young-whites/smart-fish-tank/stm32Code-official/README.md

# 基于 STM32 的智能鱼缸监控系统

## 项目简介

本项目是一款基于 STM32F103C8T6 的智能鱼缸监控系统，通过传感器实时采集水质参数（温度、水位、PH、空气质量），自动控制加热、加水、排水、增氧等执行机构，并通过 OLED 本地显示与 WiFi（ESP-01S）远程上报实现双通道人机交互。

### 核心功能

- **温度监控**：DS18B20 采集水温，滞环控制加热继电器
- **水位监控**：模拟水位传感器，区间控制加水/排水继电器
- **PH 监测**：PH 传感器采集，越限报警
- **空气质量监测**：MQ-135 采集，超标自动增氧
- **OLED 显示**：SSD1306 128×64，3 主页面 × 多子页面
- **5 键交互**：独立按键导航、阈值设置、手动控制
- **自动喂食**：SG90 舵机定时/手动触发
- **WiFi 远程控制**：ESP-01S TCP Server，Android APP 连接控制
- **声光报警**：综合越限判断，蜂鸣器 + LED 循环报警

## 系统架构

```
┌─────────────┐      ┌──────────────┐      ┌─────────────┐
│  传感器阵列  │─────▶│  STM32F103   │─────▶│  执行器阵列  │
│ DS18B20     │      │   C8T6       │      │ 加热继电器  │
│ 水位传感器  │      │  72MHz       │      │ 加水继电器  │
│ MQ-135      │      │  裸机调度    │      │ 排水继电器  │
│ PH 传感器   │      │              │      │ 增氧继电器  │
└─────────────┘      │  ┌────────┐  │      │ SG90 舵机   │
                     │  │ TIM2   │  │      │ 蜂鸣器+LED  │
┌─────────────┐      │  │ 1ms    │  │      └─────────────┘
│  OLED 显示  │◀─────│  │ 中断   │  │
│  128×64     │      │  │ 调度   │  │      ┌─────────────┐
└─────────────┘      │  └────────┘  │─────▶│  ESP-01S    │
                     │              │      │  WiFi 模组  │
┌─────────────┐      │              │      │  TCP:8080   │────▶ Android APP
│  5 按键     │─────▶│              │      └─────────────┘
│  KEY1~5     │      └──────────────┘
└─────────────┘
```

## 硬件清单

| 器件 | 型号 | 接口 | 供电 |
|---|---|---|---|
| MCU | STM32F103C8T6 | — | 3.3V |
| 温度传感器 | DS18B20 | PB13 (1-Wire) | 3.3V |
| 水位传感器 | 模拟型 | PA1 (ADC1_IN1) | 3.3V |
| PH 传感器 | 模拟型 | PA0 (ADC1_IN0) | 3.3V |
| 空气质量传感器 | MQ-135 | PA4 (ADC1_IN4) | 5V |
| OLED 显示屏 | SSD1306 0.96" | PA11(SCL)/PA12(SDA) | 3.3V |
| WiFi 模组 | ESP-01S | PA2(TX)/PA3(RX) | 3.3V |
| 加热继电器 | — | PB12 | 5V |
| 加水继电器 | — | PB14 | 5V |
| 排水继电器 | — | PB15 | 5V |
| 增氧继电器 | — | PA15 | 5V |
| 舵机 | SG90 | PA6 (TIM3_CH1) | 5V |
| 按键 | 5 个轻触 | PA8/PB3/PB4/PB8/PB1 | — |
| 蜂鸣器+LED | — | PB9 | 3.3V |

## 目录结构

```
stm32Code-official/
├── MDK_Core/               # ARM Cortex-M3 内核文件
├── MDK_STM32F10x_FWLib/    # STM32 标准外设库
├── MDK_System/             # 系统底层（delay、USART1 调试）
├── MDK_APP/                # 应用层
│   ├── MyTypedef.c/h       #   全局数据结构 (Flag + Record)
│   ├── TimingSet.c/h       #   TIM2 中断调度函数
│   └── GeneralTIM.c/h      #   TIM2 定时器配置
├── MDK_Hardware/           # 硬件驱动
│   ├── OLED/               #   OLED 显示模块（驱动+渲染+字库）
│   ├── bsp_Key.c/h         #   按键驱动
│   ├── bsp_beep.c/h        #   蜂鸣器驱动
│   ├── bsp_led.c/h         #   LED 驱动
│   ├── bsp_esp01s.c/h      #   ESP-01S WiFi 驱动
│   ├── ds18b20.c/h         #   DS18B20 温度驱动
│   └── bsp_adc.c/h         #   ADC 采集驱动
├── MDK_User/               # 用户代码
│   ├── main.c              #   系统入口
│   └── stm32f10x_it.c/h    #   中断服务函数
├── MDK_Hardware/           # 硬件原理图/PCB
├── MDK_Project/            # Keil 工程文件
└── MDK_Doc/                # 项目文档
```

## 编译与烧录

### 开发环境

- IDE：Keil MDK-ARM v5
- 编译器：ARM Compiler v5/v6
- 目标芯片：STM32F103C8T6
- 调试器：ST-Link / J-Link

### 编译步骤

1. 使用 Keil MDK-ARM 打开 `MDK_Project/` 下的 `.uvprojx` 工程文件
2. 确认 Target 选择为 `STM32F103C8`
3. 点击 Build (F7) 编译
4. 编译成功后生成 `.hex` / `.bin` 文件

### 烧录步骤

1. 连接 ST-Link 调试器到 STM32 SWD 接口
2. Keil 中 Options for Target → Debug → 选择 ST-Link
3. 点击 Download (F8) 烧录
4. 或使用 ST-Link Utility 烧录 `.hex` 文件

## 文档索引

| 文档 | 说明 |
|---|---|
| [需求规格书](MDK_Doc/智能鱼缸系统需求规格书.md) | 系统功能需求、硬件需求、性能需求 |
| [业务逻辑流程图](MDK_Doc/智能鱼缸系统业务逻辑流程图.md) | 各模块业务流程、状态转换图 |
| [代码框架与业务流程](MDK_Doc/智能鱼缸系统代码框架与业务流程.md) | 代码目录、函数调用、数据流向 |
| [OLED 显示规划](MDK_Doc/OLED显示规划.md) | OLED 页面布局、字库、渲染逻辑 |
| [WiFi 通信协议规范](MDK_Doc/WiFi通信协议规范.md) | ESP-01S 通信协议、帧格式、命令字 |
| [测试用例表](MDK_Doc/测试用例表_可勾选.md) | 功能测试用例（可勾选） |
| [项目坑点与经验总结](MDK_Doc/项目坑点与经验总结.md) | 开发过程中遇到的问题与解决方案 |

## 版本信息

| 项目 | 内容 |
|---|---|
| 项目名称 | 基于 STM32 的智能鱼缸监控系统 |
| 目标 MCU | STM32F103C8T6 (72 MHz, 3.3V) |
| 开发环境 | Keil MDK-ARM v5 |
| 操作系统 | 裸机 (Bare-Metal)，TIM2 中断调度 |
| 配套 APP | [Android 控制端](../Android_Studio_Floder/Intelligent-fish-tank-control/) |

---

*最后更新：2026-05-19*
