young-whites/smart-fish-tank/Schematic/硬件接口说明.md

| 器件 | 型号 | 接口 | 供电 | 备注 |
|---|---|---|---|---|
| MCU | STM32F103C8T6 | - | 3.3V | LQFP-48, 72MHz |
| 温度传感器 | DS18B20 | 1-Wire (PB13) | 3.3V | 防水探头型 |
| 水位传感器 | 模拟输出 | ADC1_IN1 (PA1) | 3.3V | 0~100% |
| PH 传感器 | 模拟输出 | ADC1_IN0 (PA0) | 3.3V | 0.0~14.0 |
| 空气质量传感器 | MQ-135 | ADC1_IN4 (PA4) | 5V | 模拟输出 |
| OLED 显示屏 | SSD1306 0.96" | I2C (PA11/PA12) | 3.3V | 128×64 |
| WiFi 模组 | ESP-01S | USART2 (PA2/PA3) | 3.3V | AT 指令透传 |
| 加热继电器 | - | PB12 | 5V | 高电平有效 |
| 加水继电器 | - | PB14 | 5V | 高电平有效 |
| 排水继电器 | - | PB15 | 5V | 高电平有效 |
| 增氧继电器 | - | PA15 | 5V | 高电平有效 |
| 舵机 | SG90 | PWM TIM3_CH1 (PA6) | 5V | 0~180° |
| 按键 ×5 | 轻触 | (KEY1~KEY5)依次PA8/PB3/PB4/PB8/PB1 | - | 上拉输入，高电平触发 |
| 蜂鸣器+LED | 有源 | PB9 | 3.3V | 高电平触发 |
