young-whites/smart-fish-tank/stm32Code-official/MDK_Doc/智能鱼缸系统代码框架与业务流程.md

# 智能鱼缸系统 — 代码框架与业务流程

> 版本：V1.0 | 日期：2026-05-19
> 项目：基于 STM32 的智能鱼缸监控系统
> 目标 MCU：STM32F103C8T6 (72 MHz, 3.3 V)
> 开发环境：Keil MDK-ARM v5

---

## 目录

1. [代码目录结构](#1-代码目录结构)
2. [源文件职责清单](#2-源文件职责清单)
3. [函数调用关系](#3-函数调用关系)
4. [TIM2 中断调度详细流程](#4-tim2-中断调度详细流程)
5. [全局数据结构](#5-全局数据结构)
6. [模块间数据流向](#6-模块间数据流向)
7. [主循环业务逻辑](#7-主循环业务逻辑)
8. [中断优先级配置](#8-中断优先级配置)
9. [变更记录](#9-变更记录)

---

## 1. 代码目录结构

```
stm32Code-official/
├── keilkill.bat            # Keil 工程清理脚本
├── MDK_Core/               # ARM Cortex-M3 内核文件
│   ├── core_cm3.c/h        # CMSIS Cortex-M3 核心头文件
│   ├── startup_stm32f10x_md.s  # 启动文件（中容量）
│   └── system_stm32f10x.c/h    # 系统初始化
├── MDK_STM32F10x_FWLib/    # STM32 标准外设库
│   ├── stm32f10x_gpio.c/h  # GPIO 驱动
│   ├── stm32f10x_tim.c/h   # 定时器驱动
│   ├── stm32f10x_adc.c/h   # ADC 驱动
│   ├── stm32f10x_usart.c/h # USART 驱动
│   ├── stm32f10x_rcc.c/h   # 时钟配置
│   ├── stm32f10x_i2c.c/h   # I2C 驱动
│   ├── stm32f10x_it.c/h    # 中断向量表
│   └── misc.c/h            # NVIC 配置
├── MDK_System/             # 系统底层支持
│   ├── sys.c/h             # 系统宏定义
│   ├── delay.c/h           # 延时函数（SysTick）
│   └── usart.c/h           # 调试串口 USART1
├── MDK_APP/                # 应用层逻辑
│   ├── MyTypedef.c/h       # 全局数据结构（Flag + Record）
│   ├── TimingSet.c/h       # 定时中断调度函数
│   └── GeneralTIM.c/h      # TIM2 定时器配置
├── MDK_Hardware/           # 硬件驱动层
│   ├── OLED/               # OLED 显示模块
│   │   ├── oled_drive.c/h      # I2C 软件模拟底层驱动
│   │   ├── oled_ShowDrive.c/h  # 显示底层函数（画点/线/字）
│   │   ├── oled_show.c/h       # 页面渲染逻辑
│   │   ├── oled_IndexCtr.c/h   # 页面索引控制
│   │   ├── oledChinese_6X12.h  # 6×12 汉字字库
│   │   ├── oledChinese_8X16.h  # 8×16 汉字字库
│   │   ├── oledchar_6X12.h     # 6×12 ASCII 字库
│   │   └── icon.h              # 图标资源
│   ├── bsp_Key.c/h         # 按键驱动 + 事件处理
│   ├── bsp_beep.c/h        # 蜂鸣器驱动
│   ├── bsp_led.c/h         # LED 驱动
│   ├── bsp_esp01s.c/h      # ESP-01S WiFi 驱动
│   ├── ds18b20.c/h         # DS18B20 温度传感器驱动
│   └── bsp_adc.c/h         # ADC 多通道采集驱动
├── MDK_User/               # 用户代码
│   ├── main.c              # 系统入口
│   ├── stm32f10x_it.c/h    # 中断服务函数
│   └── stm32f10x_conf.h    # 外设库头文件包含配置
├── MDK_Hardware/           # 硬件原理图/PCB 文件
└── MDK_Project/            # Keil 工程文件 (.uvprojx)
```

### 各目录职责

| 目录 | 职责 | 可修改性 |
|---|---|---|
| MDK_Core | ARM 内核启动文件 | 不修改 |
| MDK_STM32F10x_FWLib | STM32 标准外设库 | 不修改 |
| MDK_System | 系统底层（延时、调试串口） | 按需修改 |
| MDK_APP | 应用层逻辑（调度、数据结构） | 频繁修改 |
| MDK_Hardware | 硬件驱动（传感器、显示、通信） | 频繁修改 |
| MDK_User | 用户入口（main.c、中断） | 频繁修改 |
| MDK_Hardware | 硬件设计文件 | 不修改 |
| MDK_Project | Keil 工程配置 | 按需修改 |

---

## 2. 源文件职责清单

### MDK_APP — 应用层

| 文件 | 职责 | 关键函数/结构体 |
|---|---|---|
| MyTypedef.h/c | 全局数据结构定义 | `Flag_StructType`, `Record_StructType` |
| TimingSet.h/c | TIM2 中断调度函数 | `Timing_1ms()`, `Timing_5ms()`, `Timing_50ms()`, `Timing_500ms()`, `Timing_1s()`, `Servo_SetAngle()` |
| GeneralTIM.h/c | TIM2 定时器初始化 | `GENERAL_TIM_Init()` |

### MDK_Hardware — 硬件驱动

| 文件 | 职责 | 关键函数 |
|---|---|---|
| oled_drive.c/h | I2C 软件模拟底层 | `OLED_Init()`, `OLED_WriteCmd()`, `OLED_WriteData()` |
| oled_ShowDrive.c/h | 显示底层函数 | `OLED_ShowChar()`, `OLED_ShowString()`, `OLED_ShowNum()` |
| oled_show.c/h | 页面渲染逻辑 | `OLED_Show_Page()`, `OLED_ShowStart()`, `OLED_Clr_Screen()` |
| oled_IndexCtr.c/h | 页面索引控制 | 页面切换逻辑 |
| bsp_Key.c/h | 按键驱动 | `KEY_GPIO_Config()`, `KEY_Scan()`, `KEY_DrvScan()`, `KEY_Read()` |
| bsp_beep.c/h | 蜂鸣器驱动 | `Beep_Init()`, `BEEP_Blink()`, `BEEP_Off()`, `BEEP_DrvScan()` |
| bsp_led.c/h | LED 驱动 | `LED_Init()`, LED 控制函数 |
| bsp_esp01s.c/h | ESP-01S WiFi 驱动 | `ESP01S_Init()`, `ESP01S_Process()`, `ESP01S_SendSensorData()`, `ESP01S_SendDeviceStatus()`, `ESP01S_IsClientConnected()` |
| ds18b20.c/h | DS18B20 温度驱动 | `DS18B20_Init()`, `DS18B20_GetTemperture()` |
| bsp_adc.c/h | ADC 采集驱动 | `ADC_Polling_Init()` |

### MDK_User — 用户入口

| 文件 | 职责 | 关键内容 |
|---|---|---|
| main.c | 系统入口 | `main()`: 初始化 + 主循环 |
| stm32f10x_it.c | 中断服务函数 | `TIM2_IRQHandler()` |

---

## 3. 函数调用关系

### 3.1 系统启动调用链

```
main()
 ├── NVIC_PriorityGroupConfig(NVIC_PriorityGroup_4)
 ├── delay_init(72)
 ├── GENERAL_TIM_Init()              → TIM2 配置，1ms 中断
 ├── LED_Init()
 ├── Beep_Init()
 ├── KEY_GPIO_Config()
 ├── OLED_Init()                     → PA11/PA12 I2C 初始化
 ├── DS18B20_Init()                  → PB13 初始化
 ├── ADC_Polling_Init()              → PA0/PA1/PA4 ADC 配置
 ├── Debug_USART1_Init()             → 调试串口
 ├── ESP01S_Init()                   → USART2 + ESP-01S AT 配置
 ├── GPIO 继电器初始化               → PB12/PB14/PB15/PA15
 ├── GPIO 舵机初始化                 → PA6 TIM3_CH1
 ├── 全局变量初始化 (Flag + Record)
 ├── TIM_Cmd(TIM3, ENABLE)           → 启动舵机 PWM
 ├── Servo_SetAngle(0)               → 舵机归零
 ├── OLED_ShowStart()                → 启动画面
 ├── delay_ms(2000)
 └── while(1) 主循环
```

### 3.2 主循环调用链

```
while(1)
 ├── DS18B20 温度读取（每 ~1s）
 │    └── DS18B20_GetTemperture() → Record.waterTemp
 ├── 继电器互斥安全检查（Fill/Drain）
 ├── GPIO 继电器输出
 │    └── GPIO_WriteBit() × 4
 ├── OLED 页面切换检测 + 刷新
 │    └── OLED_Show_Page(currentPage)
 ├── ESP01S_Process()               → WiFi 数据接收处理
 ├── ESP01S_SendSensorData()        → 传感器数据上报（每 ~3s）
 └── delay_ms(100)
```

### 3.3 TIM2 中断调用链

```
TIM2_IRQHandler()
 ├── Timing_1ms()                   → KEY_DrvScan() 按键底层扫描
 ├── Timing_2ms()                   → (空)
 ├── Timing_5ms()                   → ADC 三通道轮询采集
 │    ├── 水位 PA1 → Record.waterLevel
 │    ├── PH PA0  → Record.phValue
 │    └── 空气 PA4 → Record.airQuality
 ├── Timing_10ms()                  → (空)
 ├── Timing_50ms()                  → KEY_Scan() 按键消抖 + 事件生成
 ├── Timing_500ms()
 │    ├── 自动控制逻辑（仅自动模式）
 │    │    ├── 温度滞环控制 → Flag.relayHeat
 │    │    ├── 水位区间控制 → Flag.relayFill / Flag.relayDrain
 │    │    └── 空气质量控制 → Flag.relayOxygen
 │    └── 报警检查 → BEEP_Blink() / BEEP_Off()
 └── Timing_1s()
      ├── 手动模式安全超时（60s 自动关闭继电器）
      ├── 喂食控制（倒计时 + 舵机动作）
      └── Servo_SetAngle()
```

---

## 4. TIM2 中断调度详细流程

### 4.1 调度时序图

```
时间轴 (ms)  0    1    2    3    4    5    ...  10   ...  50   ...  500  ...  1000
             │    │    │    │    │    │         │         │         │         │
TIM2 中断    ▼    ▼    ▼    ▼    ▼    ▼         ▼         ▼         ▼         ▼
             │    │    │    │    │    │         │         │         │         │
1ms 任务     ■    ■    ■    ■    ■    ■    ...  ■    ...  ■    ...  ■    ...  ■
(KEY_DrvScan)
             │    │    │    │    │    │         │         │         │         │
2ms 任务          ■         ■         ■              ■              ■
(保留)
             │    │    │    │    │    │         │         │         │         │
5ms 任务               ■              ■              ■              ■
(ADC采集 每3次)
             │    │    │    │    │    │         │         │         │         │
10ms 任务                                            ■
(保留)
             │    │    │    │    │    │         │         │         │         │
50ms 任务                                                                ■
(KEY_Scan)
             │    │    │    │    │    │         │         │         │         │
500ms 任务                                                                                    ■
(自动控制+报警)
             │    │    │    │    │    │         │         │         │         │
1s 任务                                                                                                          ■
(喂食+超时)
```

### 4.2 各周期任务详解

| 周期 | 函数 | 执行内容 | 耗时估算 |
|---|---|---|---|
| 1 ms | `Timing_1ms()` | `KEY_DrvScan()` — 读取 5 个按键 GPIO 电平，写入按键缓冲区 | < 10 μs |
| 2 ms | `Timing_2ms()` | 保留（空函数） | — |
| 5 ms | `Timing_5ms()` | ADC 三通道轮询（实际每 15ms 完成一轮）：水位→PH→空气质量 | ~200 μs |
| 10 ms | `Timing_10ms()` | 保留（空函数） | — |
| 50 ms | `Timing_50ms()` | `KEY_Scan()` — 连续 3 次消抖确认，生成按键事件 | < 20 μs |
| 500 ms | `Timing_500ms()` | 自动控制逻辑（温度/水位/空气质量）+ 报警判断 | < 50 μs |
| 1 s | `Timing_1s()` | 手动模式安全超时、喂食倒计时、舵机控制 | < 50 μs |

### 4.3 中断优先级

| 中断 | 抢占优先级 | 子优先级 | 说明 |
|---|---|---|---|
| TIM2 | 2 | 0 | 系统调度心跳 |
| USART2 (WiFi) | — | — | 串口接收中断 |
| USART1 (Debug) | — | — | 调试串口 |

---

## 5. 全局数据结构

### 5.1 Flag_StructType（系统标志位）

定义于 `MDK_APP/MyTypedef.h`

```c
typedef struct
{
    uint8_t    currentPage;       // Current main page: 0=Home, 1=Threshold, 2=Manual
    uint8_t    subPage;           // Current sub page
    uint8_t    thresholdField;    // 0=select lower, 1=select upper
    uint8_t    thresholdIndex;    // Current selected threshold param index 0-6
    uint8_t    alarmEnable;       // Alarm: 0=off, 1=on
    uint8_t    feeding;           // Feed status: 0=idle, 1=feeding
    uint8_t    relayHeat;         // Heat relay state
    uint8_t    relayFill;         // Fill relay state
    uint8_t    relayDrain;        // Drain relay state
    uint8_t    relayOxygen;       // Oxygen relay state
    uint8_t    sensorError;       // Error flags: bit0=DS18B20, bit1=ADC
    uint16_t   manualTimeout;     // Manual safety timeout (seconds)
} Flag_StructType;
```

**标志位操作规则**：
- `currentPage` / `subPage`：由按键事件修改，OLED 显示读取
- `relayXxx`：自动模式由 `Timing_500ms()` 修改；手动模式由按键修改
- `sensorError`：DS18B20 读取异常时置位 bit0
- `manualTimeout`：手动模式下继电器开启后递减，归零自动关闭所有继电器

### 5.2 Record_StructType（传感器数据与阈值）

定义于 `MDK_APP/MyTypedef.h`

```c
typedef struct
{
    float      waterTemp;         // Water temperature °C
    float      phValue;           // pH value 0.0~14.0
    uint8_t    waterLevel;        // Water level 0~100%
    uint16_t   airQuality;        // Air quality (processed value 0~20)
    uint8_t    runMode;           // 0=Auto, 1=Manual
    int16_t    feedCountdown;     // Feed countdown (sec)
    uint16_t   feedInterval;      // Feed interval (sec), default 30

    // Thresholds
    float      tempLower;         // Temperature lower limit (default 20.0)
    float      tempUpper;         // Temperature upper limit (default 35.0)
    uint16_t   airQualityMax;     // Air quality upper limit (default 12)
    float      phLower;           // PH lower limit (default 4.0)
    float      phUpper;           // PH upper limit (default 8.0)
    uint8_t    waterLevelMin;     // Water level lower limit % (default 50)
    uint8_t    waterLevelMax;     // Water level upper limit % (default 70)
} Record_StructType;
```

**数据读写规则**：

| 字段 | 写入者 | 读取者 | 周期 |
|---|---|---|---|
| waterTemp | main.c DS18B20 读取 | OLED / 报警 / WiFi 上报 | ~1s |
| phValue | Timing_5ms() ADC | OLED / 报警 / WiFi 上报 | 15ms |
| waterLevel | Timing_5ms() ADC | OLED / 报警 / WiFi 上报 | 15ms |
| airQuality | Timing_5ms() ADC | OLED / 报警 / WiFi 上报 | 15ms |
| runMode | 按键 / WiFi 命令 | 自动控制 / OLED | — |
| feedCountdown | Timing_1s() | OLED / WiFi 上报 | 1s |
| relayXxx | 自动控制 / 按键 / WiFi | GPIO 输出 / OLED / WiFi | 100ms |

---

## 6. 模块间数据流向

### 6.1 传感器 → 显示/控制/上报

```
DS18B20 (PB13)                  Timing_5ms()
    │                               │
    ▼                               ▼
DS18B20_GetTemperture()        ADC_三通道轮询
    │                          (PA0/PA1/PA4)
    │                               │
    ▼                               ▼
Record.waterTemp ──────────┬──▶ OLED_Show_Page() ──▶ OLED 屏幕显示
Record.phValue   ◀─────────┤
Record.waterLevel ◀────────┤──▶ Timing_500ms() ──▶ 自动控制逻辑
Record.airQuality ◀────────┤       │                    │
                           │       ▼                    ▼
                           │   Flag.relayXxx ──▶ GPIO_WriteBit() ──▶ 继电器
                           │
                           └──▶ ESP01S_SendSensorData() ──▶ WiFi 上报
```

### 6.2 按键 → 系统状态变更

```
KEY_DrvScan() (1ms)     KEY_Scan() (50ms)
    │                        │
    ▼                        ▼
按键电平缓冲 ────────▶ 消抖确认 + 事件生成
                              │
                              ▼
                     KEY_Read() / 按键事件
                              │
                 ┌────────────┼────────────┐
                 │            │            │
            页面切换      阈值调整      模式切换
                 │            │            │
                 ▼            ▼            ▼
           Flag.currentPage  Record.xxx   Flag.relayXxx
           Flag.subPage      (阈值字段)   Record.runMode
                 │
                 ▼
           OLED_Show_Page()
```

### 6.3 WiFi 双向通信

```
                    ┌─────────────────────────────┐
                    │         ESP-01S             │
                    │      (TCP Server :8080)     │
                    └──────┬──────────┬───────────┘
                           │          │
                      +IPD 数据    AT 响应
                           │          │
                           ▼          ▼
                    ESP01S_Process() ──▶ 命令解析
                           │
              ┌────────────┼──────────────┐
              │            │              │
         CMD_SWITCH    CMD_CONTROL    CMD_SYNC
         _MODE         _RELAY         _THRESHOLDS
              │            │              │
              ▼            ▼              ▼
         Record.runMode  Flag.relayXxx  Record.xxx
                                  (阈值字段)
              
              ┌─────────────────────────────┐
              │    ESP01S_SendSensorData()  │ ◀── 主循环每 ~3s
              │    ESP01S_SendDeviceStatus()│ ◀── 状态变更时
              └─────────────────────────────┘
```

---

## 7. 主循环业务逻辑

### 7.1 main.c 主循环流程

```
while(1)
{
    ① DS18B20 温度读取（每 ~1s, 含断线检测）
       └── 有效值 → Record.waterTemp
       └── 异常值 → Flag.sensorError |= 0x01, 保持上次值
    
    ② 继电器互斥安全检查
       └── Fill + Drain 同时 ON → Drain 优先, Fill 清零
    
    ③ GPIO 继电器输出
       └── PB12(加热) PB14(加水) PB15(排水) PA15(增氧)
    
    ④ OLED 页面切换检测 + 刷新
       └── curPage = currentPage * 10 + subPage
       └── 页面变化 → OLED_Clr_Screen() + OLED_Show_Page()
    
    ⑤ ESP01S_Process() — WiFi 数据接收处理
    
    ⑥ 传感器数据上报（每 ~3s）
       └── 新连接时立即上报一次
       └── ESP01S_SendSensorData()
    
    ⑦ delay_ms(100) — 100ms 主循环周期
}
```

### 7.2 自动控制逻辑（Timing_500ms）

仅在 `Record.runMode == 0`（自动模式）下执行：

```
温度控制（滞环）:
    if waterTemp < tempLower  → relayHeat = 1 (开加热)
    if waterTemp > tempUpper  → relayHeat = 0 (关加热)
    中间区间 → 保持不变

水位控制（区间）:
    if waterLevel > waterLevelMax → relayDrain=1, relayFill=0 (排水)
    if waterLevel < waterLevelMin → relayFill=1, relayDrain=0 (加水)
    安全区间 → relayFill=0, relayDrain=0

空气质量控制（阈值）:
    if airQuality < airQualityMax → relayOxygen=1 (开增氧)
    else → relayOxygen=0 (关增氧)
```

---

## 8. 中断优先级配置

### 8.1 NVIC 分组

采用 `NVIC_PriorityGroup_4`：4 位抢占优先级，0 位子优先级。

### 8.2 中断源配置

| 中断源 | 抢占优先级 | 子优先级 | 说明 |
|---|---|---|---|
| TIM2 | 2 | 0 | 系统调度心跳（1ms） |
| USART1 | — | — | 调试串口（printf） |
| USART2 | — | — | ESP-01S 串口接收 |

### 8.3 设计原则

- TIM2 中断优先级设为 2，确保不阻塞更高优先级的通信中断
- 所有传感器读取（DS18B20）放在主循环而非中断中，避免中断阻塞
- ADC 采集在 TIM2 中断中执行（5ms 周期），但采用顺序轮询非 DMA

---

## 9. 变更记录

| 版本 | 日期 | 主要改动 |
|---|---|---|
| V1.0 | 2026-05-19 | 初始版本，基于代码分析创建 |

---

*文档结束 — 智能鱼缸系统代码框架与业务流程 V1.0*
