young-whites/smart-fish-tank/Schematic/Schematic.pdf

## U2STM³²F103C8T6核心板

## SWD

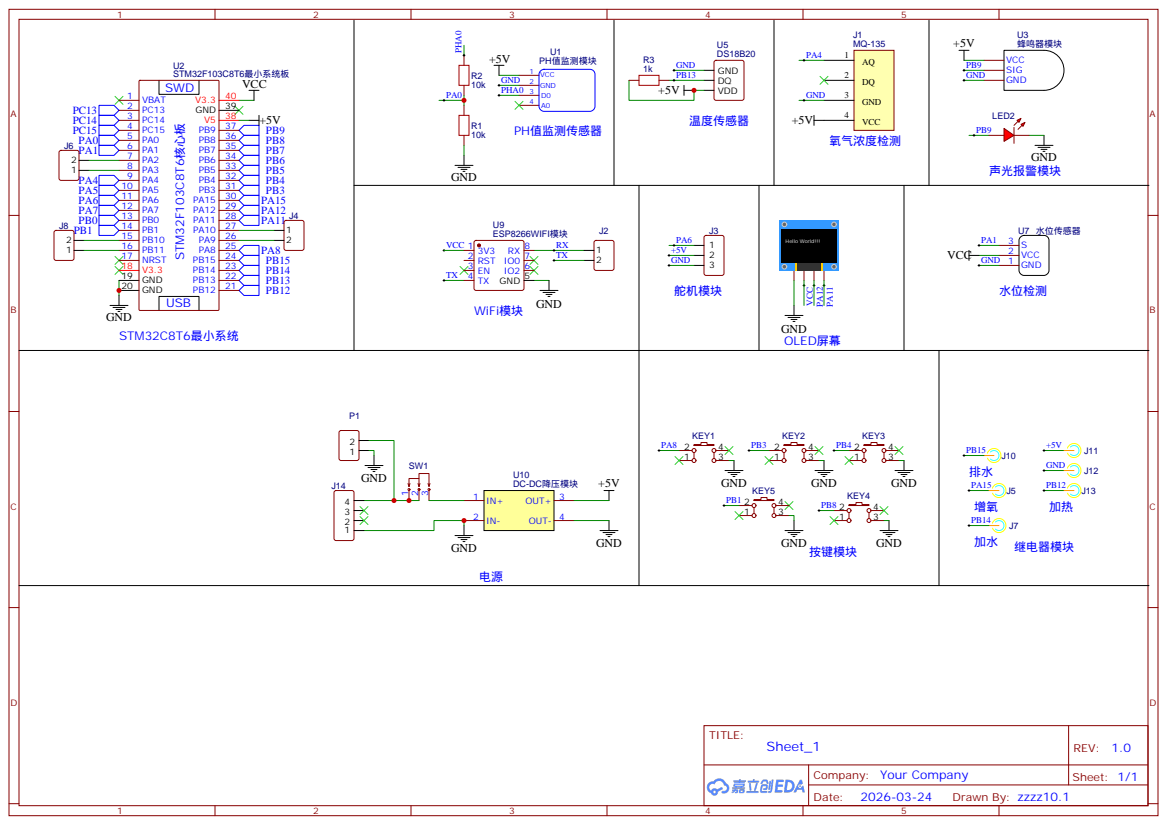
[picture p1: page 1]
