young-whites/smart-fish-tank/stm32Code-official/MDK_User/main.c

#include <stdio.h>	 	 
#include <string.h>	
#include <stdarg.h>
#include "sys.h"
#include "bsp_Key.h"
#include "oled_show.h"
#include "MyTypedef.h"
#include "ds18b20.h"
#include "bsp_adc.h"
#include "bsp_esp01s.h"
#include "TimingSet.h"

extern volatile uint32_t TimeCnt_ms;

/*******************************************/
/*              Interrupt Priority          */
/*-----------------------------------------*/
/*	TIM2    -> Preempt priority 2  Sub priority 0
 */

int main ( void )
{	
	NVIC_PriorityGroupConfig(NVIC_PriorityGroup_4);
	delay_init(72);
	GENERAL_TIM_Init();

	LED_Init();
	Beep_Init();
	KEY_GPIO_Config();
	OLED_Init();
	DS18B20_Init();
	ADC_Polling_Init();
	Debug_USART1_Init();
	printf("\r\n[SYS] System starting...\r\n");
	ESP01S_Init();

	/* Relay GPIO initialization */
	{
		GPIO_InitTypeDef GPIO_InitStructure;
		RCC_APB2PeriphClockCmd(RCC_APB2Periph_GPIOA | RCC_APB2Periph_GPIOB, ENABLE);
		GPIO_InitStructure.GPIO_Pin = GPIO_Pin_12 | GPIO_Pin_14 | GPIO_Pin_15;
		GPIO_InitStructure.GPIO_Mode = GPIO_Mode_Out_PP;
		GPIO_InitStructure.GPIO_Speed = GPIO_Speed_50MHz;
		GPIO_Init(GPIOB, &GPIO_InitStructure);

		GPIO_InitStructure.GPIO_Pin = GPIO_Pin_15;
		GPIO_Init(GPIOA, &GPIO_InitStructure);

		/* Default: turn off all relays */
		GPIO_ResetBits(GPIOB, GPIO_Pin_12 | GPIO_Pin_14 | GPIO_Pin_15);
		GPIO_ResetBits(GPIOA, GPIO_Pin_15);
	}

	/* Servo PA6: TIM3_CH1 PWM output */
	{
		GPIO_InitTypeDef GPIO_InitStructure;
		RCC_APB2PeriphClockCmd(RCC_APB2Periph_GPIOA, ENABLE);
		GPIO_InitStructure.GPIO_Pin = GPIO_Pin_6;
		GPIO_InitStructure.GPIO_Mode = GPIO_Mode_AF_PP;
		GPIO_InitStructure.GPIO_Speed = GPIO_Speed_50MHz;
		GPIO_Init(GPIOA, &GPIO_InitStructure);
	}

	/* Global variable initialization */
	Flag.currentPage = 0;
	Flag.subPage = 0;
	Flag.thresholdField = 0;
	Flag.thresholdIndex = 0;
	Flag.alarmEnable = 1;
	Flag.feeding = 0;
	Flag.relayHeat = 0;
	Flag.relayFill = 0;
	Flag.relayDrain = 0;
	Flag.relayOxygen = 0;
	Flag.sensorError = 0;
	Flag.manualTimeout = 60;

	Record.waterTemp = 0.0f;
	Record.phValue = 7.2f;
	Record.waterLevel = 65;
	Record.airQuality = 20;
	Record.runMode = 0;
	Record.feedCountdown = 0;
	Record.feedInterval = 30;
	Record.tempLower = 20.0f;
	Record.tempUpper = 35.0f;
	Record.airQualityMax = 12;
	Record.phLower = 4.0f;
	Record.phUpper = 8.0f;
	Record.waterLevelMin = 50;
	Record.waterLevelMax = 70;

	/* Enable TIM3 for servo PWM */
	TIM_Cmd(TIM3, ENABLE);
	Servo_SetAngle(0);  /* Servo initial position */

	/* Show startup screen */
	OLED_ShowStart();
	delay_ms(2000);
	OLED_Clr_Screen();

	static uint8_t lastPage = 0xFF;
	uint8_t curPage;

	while ( 1 )
	{
		/* DS18B20 read with fault detection (outside ISR to avoid blocking) */
		{
			static uint32_t dsReadCnt = 0;
			if (++dsReadCnt >= 10) {   /* Every ~1s at 100ms loop */
				dsReadCnt = 0;
				float t = DS18B20_GetTemperture();
				if (t > -50.0f && t < 125.0f) {
					Record.waterTemp = t;
					Flag.sensorError &= ~0x01;
				} else {
					Flag.sensorError |= 0x01;
				}
			}
		}

		/* Fill/Drain mutual exclusion safety */
		if (Flag.relayFill && Flag.relayDrain) {
			Flag.relayDrain = 0;  /* Drain takes priority */
		}

		/* Relay GPIO output */
		GPIO_WriteBit(GPIOB, GPIO_Pin_12, Flag.relayHeat ? Bit_SET : Bit_RESET);
		GPIO_WriteBit(GPIOB, GPIO_Pin_14, Flag.relayFill ? Bit_SET : Bit_RESET);
		GPIO_WriteBit(GPIOB, GPIO_Pin_15, Flag.relayDrain ? Bit_SET : Bit_RESET);
		GPIO_WriteBit(GPIOA, GPIO_Pin_15, Flag.relayOxygen ? Bit_SET : Bit_RESET);

		/* Page change detection and clear screen */
		curPage = Flag.currentPage * 10 + Flag.subPage;
		if (curPage != lastPage) {
			lastPage = curPage;
			OLED_Clr_Screen();
		}

		/* Refresh OLED display */
		OLED_Show_Page(Flag.currentPage);

		ESP01S_Process();

		/* Sensor data upload to APP */
		{
			static uint32_t uploadCnt = 0;
			static uint8_t  lastClientState = 0;
			uint8_t curClientState = ESP01S_IsClientConnected();

			/* On new connection: send immediately and reset counter */
			if (curClientState && !lastClientState) {
				uploadCnt = 28; /* Trigger on next iteration (~200ms) */
			}
			lastClientState = curClientState;

			if (++uploadCnt >= 30) {  /* ~3s at 100ms loop */
				uploadCnt = 0;
				ESP01S_SendSensorData();
			}
		}

		delay_ms(100);
	}
}


/*********************************************END OF FILE**********************/
