young-whites/smart-fish-tank/stm32Code-official/MDK_Hardware/OLED/oledChinese_6X12.h

#ifndef _OLEDCHINESE_6X12_H
#define _OLEDCHINESE_6X12_H
#include "stm32f10x.h"





//结构体的第一个成员name[3]用来存放汉字的区码和位码以及一个字符串结束字符'\0'，这里的'\0'不是必要的
//结构体的第二个成员dat[32]用来存放汉字点阵数据，这里采用的12*12的汉字  ---> 12*12/8=32，故单个汉字的点阵数据为32字节
typedef struct {
    char name[3];
    char dat[32];
}Optimized_Chinese6X12;




//-----------------------------------------------------------------------------------------
//适用于区位码的字库
//字体大小 6*12（12*12）
//字体：宋体
//取模走向：列行式 逆向  阴码
//取模软件：PCtoLCD2002
Optimized_Chinese6X12 Hzk12[] = {
"上",
{0x00,0x00,0x00,0x00,0xFF,0x10,0x10,0x10,0x10,0x10,0x00,0x00,0x08,0x08,0x08,0x08,0x0F,0x08,0x08,0x08,0x08,0x08,0x08,0x00},/*"上",0*/
"下",
{0x02,0x02,0x02,0x02,0xFE,0x02,0x12,0x22,0x42,0x82,0x02,0x00,0x00,0x00,0x00,0x00,0x0F,0x00,0x00,0x00,0x00,0x01,0x00,0x00},/*"下",1*/
"位",
{0x10,0xFC,0x03,0x08,0x68,0x88,0x09,0x0A,0x08,0xE8,0x08,0x00,0x00,0x0F,0x00,0x08,0x08,0x0B,0x08,0x0C,0x0B,0x08,0x08,0x00},/*"位",2*/
"值",
{0x10,0xFC,0x03,0x00,0xFA,0xAA,0xAF,0xAA,0xAA,0xFA,0x02,0x00,0x00,0x0F,0x00,0x08,0x0F,0x0A,0x0A,0x0A,0x0A,0x0F,0x08,0x00},/*"值",3*/
"关",
{0x40,0x48,0x49,0x4A,0x48,0xF8,0x48,0x4A,0x49,0x48,0x40,0x00,0x08,0x08,0x04,0x02,0x01,0x00,0x01,0x02,0x04,0x08,0x08,0x00},/*"关",4*/
"制",
{0x18,0xD6,0x54,0xFF,0x54,0xD4,0x10,0xFC,0x00,0x00,0xFF,0x00,0x00,0x07,0x00,0x0F,0x04,0x07,0x00,0x01,0x08,0x08,0x0F,0x00},/*"制",5*/
"加",
{0x08,0x08,0xFF,0x08,0x08,0xF8,0x00,0xFC,0x04,0x04,0xFC,0x00,0x08,0x06,0x01,0x08,0x08,0x07,0x00,0x0F,0x04,0x04,0x0F,0x00},/*"加",6*/
"动",
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
//适用于索引的字库
//字体大小 6*12（12*12）
//字体：宋体
//取模走向：列行式 逆向  阴码
//取模软件：PCtoLCD2002
unsigned char Chinese_6X12[][12]=
{

{0x00,0x00,0x00,0x00,0xFF,0x10,0x10,0x10,0x10,0x10,0x00,0x00},
{0x08,0x08,0x08,0x08,0x0F,0x08,0x08,0x08,0x08,0x08,0x08,0x00},/*"上",0*/


};



#endif /*OLED_CHINESE_6X12_H*/
