young-whites/smart-fish-tank/stm32Code-official/MDK_System/bsp_adc.c

#include "bsp_adc.h"



/**
 * @brief  ADC1 polling mode initialization
 *         Configures PA0, PA1, PA4 as analog inputs
 *         ADC1 independent mode, single conversion, software trigger
 */
void ADC_Polling_Init(void)
{
    GPIO_InitTypeDef GPIO_InitStructure;
    ADC_InitTypeDef ADC_InitStructure;

    /* Enable GPIOA and ADC1 clock */
    RCC_APB2PeriphClockCmd(RCC_APB2Periph_GPIOA | RCC_APB2Periph_ADC1, ENABLE);

    /* Configure PA0(IN0), PA1(IN1), PA4(IN4) as analog input */
    GPIO_InitStructure.GPIO_Pin = GPIO_Pin_0 | GPIO_Pin_1 | GPIO_Pin_4;
    GPIO_InitStructure.GPIO_Mode = GPIO_Mode_AIN;
    GPIO_Init(GPIOA, &GPIO_InitStructure);

    /* ADC1 configuration */
    ADC_InitStructure.ADC_Mode = ADC_Mode_Independent;
    ADC_InitStructure.ADC_ScanConvMode = DISABLE;
    ADC_InitStructure.ADC_ContinuousConvMode = DISABLE;
    ADC_InitStructure.ADC_ExternalTrigConv = ADC_ExternalTrigConv_None;
    ADC_InitStructure.ADC_DataAlign = ADC_DataAlign_Right;
    ADC_InitStructure.ADC_NbrOfChannel = 1;
    ADC_Init(ADC1, &ADC_InitStructure);

    /* ADC clock = PCLK2/8 = 9MHz */
    RCC_ADCCLKConfig(RCC_PCLK2_Div8);

    /* Enable ADC1 */
    ADC_Cmd(ADC1, ENABLE);

    /* ADC stabilization delay (at least 1us per datasheet) */
    { volatile uint32_t d; for(d=0; d<1000; d++); }

    /* Calibration */
    ADC_ResetCalibration(ADC1);
    while (ADC_GetResetCalibrationStatus(ADC1));
    ADC_StartCalibration(ADC1);
    while (ADC_GetCalibrationStatus(ADC1));
}


uint16_t ADC_ReadChannel(uint8_t channel)
{
    ADC_RegularChannelConfig(ADC1, channel, 1, ADC_SampleTime_55Cycles5);
    ADC_SoftwareStartConvCmd(ADC1, ENABLE);
    while(!ADC_GetFlagStatus(ADC1, ADC_FLAG_EOC));
    return ADC_GetConversionValue(ADC1);
}
