young-whites/smart-fish-tank/(commit log)

2026-05-02 feat: 添加完整STM32项目代码 + README文档
    - 添加 STM32F103 智能鱼缸控制代码 (硬件驱动/应用层/系统层)
    - 添加电路原理图
    - 添加 WiFi 通信协议文档和业务流程文档
    - WiFi 连接失败自动进入离线模式，后台每秒重试
    - OLED 主页显示 WiFi 状态 (W+/W-)
    - 更新 .gitignore 排除 Keil 编译产物
2026-05-02 fix: OLED I2C 时序添加延时，修复72MHz下通信过快问题
    [oled_ShowDrive.c, oled_ShowDrive.h, oled_drive.c, oled_drive.h]
2026-05-02 test: OLED_ShowStart 改为英文测试，排查中文编码问题
2026-05-02 fix: 修复 oled_show.c 重复定义，OLED_ShowStart 改为英文测试
    [oled_show.c]
2026-05-02 feat: RT-Thread 智能鱼缸系统完整代码重构
    - app_data: 全局数据结构 + IPC (mutex/sem/mb)
    - app_sensor: DS18B20 + ADC 传感器采集线程
    - app_control: 4路继电器自动控制线程
    - app_display: OLED 页面显示线程
    - app_key: 5键消抖扫描线程
    - app_alarm: 邮箱驱动声光报警线程
    - app_feed: 舵机喂食控制线程
    - app_wifi: ESP-01S WiFi 通信线程
    - drv_oled: SSD1306 软件 I2C 驱动
    - docs: 更新 RT-Thread 版文档
    修复: HAL依赖头文件, rt_sem_init API, 编译错误
    [main.c]
2026-05-02 refactor: RT-Thread Nano 全面重写，纯CMSIS寄存器操作
    - 移除所有 HAL 依赖
    - GPIO/ADC/USART/TIM 改用 CMSIS 寄存器
    - rt_thread_init 静态栈分配
    - 源码 ~39KB，适配 64KB Flash
2026-05-02 docs: 添加 OLED 中文字库需求文档（33个汉字）
2026-05-02 feat: 集成16x16汉字字库驱动 + OLED中文显示 + 页面翻页逻辑 + 测试用例
    - font_lib: 新增16x16汉字点阵驱动(二分查找+UTF-8解析)，32个汉字
    - drv_oled: 新增 oled_draw_chinese_char/string/mix_line 混合字体绘制
    - app_display: 重构为三页面+子页翻页(KEY1切页面/KEY2切子页)
    - docs: 更新需求规格书(按键表+OLED布局)，新增测试用例表(94条)
    - docs: 新增可勾选版测试用例表(GFM checkbox格式)
2026-05-03 fix: 按键隔离 + 排版对齐 + 显示栈扩容 + 文档同步
    - app_display: handle_key_event 返回是否需刷新，无效按键不刷屏
    - app_display: 修复 KEY4 死代码，明确各页面按键生效范围
    - app_display: 显示线程栈 1024→2048 (rt_snprintf浮点+汉字渲染)
    - drv_oled: 新增 oled_draw_char_offset 支持Y偏移对齐
    - drv_oled: oled_draw_mix_line ASCII下移2px对齐汉字基线
    - drv_oled: oled_draw_chinese_char 增加缓冲区越界保护
    - docs: 同步更新按键隔离规则、混合行布局、线程栈大小
2026-05-03 fix: 显示线程栈2048→1536，修复RAM溢出516字节
2026-05-03 fix: 字体数据显式放入.rodata(Flash)，栈改回1024
    - font_lib.c: bin_data和unicode_table加__attribute__((section(.rodata)))
    - app_display.c: 栈改回1024
    - docs: 同步更新
2026-05-03 opt: 各线程栈精简，节省约1KB RAM
    - wifi_stack: 1024→768 (-256B)
    - sensor_stack: 512→384 (-128B)
    - alarm_stack: 512→384 (-128B)
    - key_stack: 512→256 (-256B)
    - feed_stack: 512→384 (-128B)
    - frame_buf: 256→128 (-128B)
    - docs: 同步更新线程架构表
2026-05-03 opt: 阈值/手动页改纯ASCII，display_stack降至512，精简font_lib
    - app_display.c: 重写阈值/手动页为纯ASCII英文，栈512
    - font_lib.c: 移除未使用的 font_draw_char/font_draw_string/utf8_decode
    - font_lib.h: 清理无用声明
    - drv_oled.c: 移除未使用的 oled_draw_chinese_string
    - drv_oled.h: 清理声明
    - docs: 同步更新页面布局和线程栈
2026-05-03 fix: 阈值页布局与文档一致 (3项P1+4项P2,光标<<,数据从page1开始)
2026-05-03 ui: 阈值/手动页数值右对齐，单位列固定，排版整齐
2026-05-03 opt: OLED局部刷新，页面切换才整体清除，定时更新只刷数据区域
    - 新增 page_changed 标志区分完整/局部刷新
    - 主页: 汉字label只在页面切换时绘制，数据区域每秒局部更新
    - 阈值/手动页: 同理只清数据区+重绘
    - 新增 clear_buf_region 工具函数
    - docs: 同步更新刷新策略说明
2026-05-03 feat: DS18B20 温度采集完善 (CRC校验+精度提升+断线检测)
    - app_sensor.c: 新增 CRC8 校验, 读取完整9字节scratchpad
    - app_sensor.c: 精度从0.1C提升到0.0625C (raw_to_float)
    - app_sensor.c: 新增 g_sensor_temp_valid 传感器在线标志
    - app_sensor.c: 返回码区分 0=成功/1=无响应/2=CRC错误
    - app_sensor.h: 导出 g_sensor_temp_valid
    - app_display.c: 温度显示2位小数, 断线显示 '--.-C'
2026-05-03 fix: oled_clear_region 移到 drv_oled.c 修复编译错误
2026-05-03 feat: ADC传感器计算完善 (8次均值滤波+标定公式+电压转换)
    - app_sensor.c: 新增 adc_read_avg 8次均值滤波
    - app_sensor.c: 新增 adc_to_voltage ADC→电压转换
    - app_sensor.c: calc_air_quality ADC→0~999空气质量指数
    - app_sensor.c: calc_water_level ADC→0~100%水位百分比
    - app_sensor.c: calc_ph_value 中性标定+斜率修正, 限幅0~14
2026-05-03 fix: 栈溢出导致黑屏+数据不显示 (display768, sensor512, alarm512)
2026-05-03 feat: FinSH 调试命令 temp/sensor
    - temp: 显示DS18B20温度 (在线/offline)
    - sensor: 显示全部传感器数据 (温度/空气/水位/PH/模式)
2026-05-03 fix: DS18B20 时序对齐参考驱动 (Reset切输入+Read Bit独立+750us)
    修复3个关键时序问题:
    1. Reset后必须切输入模式, 否则推挽输出阻塞传感器presence pulse
    2. Read Bit独立函数, 采样前等12μs确保数据稳定
    3. Reset拉低从500us改为750us, 符合DS18B20规格
    4. 读字节改为MSB first对齐参考驱动
2026-05-03 feat: FinSH sensor命令显示ADC原始值+电压(mV)
2026-05-03 fix: 删除未使用的 ds18b20_valid 变量
2026-05-03 fix: DS18B20 移除CRC校验，只读2字节(对齐参考代码)
2026-05-03 fix: delay_us加nop防优化+Read Byte内联消除函数调用时序偏差
2026-05-03 feat: 移植RTT官方DS18B20组件 (rt_pin_api + rt_hw_us_delay)
    - 完全使用RT-Thread pin设备框架, 替换直接寄存器操作
    - 使用rt_hw_us_delay(SysTick), 精度远超手写delay_us
    - 温度值改用int32_t temp_x10 (避免printf %f兼容问题)
    - 删除旧的CMSIS寄存器DS18B20驱动
2026-05-03 chore: 添加ds18b20-latest到gitignore
2026-05-03 fix: RT-Thread Nano 无rtdevice, DS18B20改回CMSIS+SysTick延时
    - delay_us改用SysTick (精度1μs, 不被编译器优化)
    - 时序参数完全对齐RTT组件 (780us/40us/5us/50us)
    - 去掉rtdevice依赖, 纯CMSIS寄存器操作
2026-05-03 fix: delay_us改用HAL_RCC_GetHCLKFreq动态计算, 不依赖SysTick
    - 原SysTick方案在时钟切换后LOAD值可能不准(偏差9倍)
    - 新方案用内联汇编+HAL时钟频率, 精度±25%
    [main.c]
2026-05-03 config: 换板引脚映射 KEY1~5=PA6/PA7/PB0/PB10/PB11 DS18B20=PB1
2026-05-03 fix: 按键改为高电平有效(下拉输入+IDR取反)
2026-05-03 fix: 混合行ASCII下移3px对齐汉字基线
2026-05-03 fix: 主页改纯ASCII避免汉字渲染栈溢出导致黑屏
    - 三个页面全部使用oled_draw_string纯ASCII
    - 移除主页的oled_draw_mix_line调用
    - 移除app_display.c的font_lib.h依赖
2026-05-03 fix: 全面移除rt_snprintf %f, 栈增至1024, 加调试命令dpage/dset
2026-05-03 feat: 新增8x16字体, 三页面全面使用大字体显示
    - 新增 font_8x16.c/h 95个ASCII字符 8x16点阵 (1520B Flash)
    - drv_oled: 新增 oled_draw_char_8x16/string_8x16 (含转置)
    - app_display: 全部改用 oled_draw_string_8x16
    - 每屏4行(每行2page), 每行16字符
2026-05-03 config: KEY4=PA3 KEY5=PA4, 改回6x12字体, 清理8x16相关代码
2026-05-03 config: KEY3=PA4 KEY5=PB0, 6x12字体下移2px居中(行间距优化)
2026-05-03 fix: DS18B20 完全对齐参考代码 (简单while循环+12us采样) + KEY4=PA5
2026-05-03 feat: 新增FinSH clk命令查看系统时钟频率
2026-05-04 正式版程序
2026-05-04 fix: repair hardware pins + complete sensor acquisition and auto control logic
    [GeneralTIM.c, GeneralTIM.h, MyTypedef.h, TimingSet.c, TimingSet.h, bsp_Key.c, bsp_Key.h]
2026-05-04 fix: switch ADC from DMA to polling mode to resolve conflict with Timing_5ms channel switching
    - Added ADC_Polling_Init() to bsp_adc.c/.h (PA0/PA1/PA4 analog input, single conversion, software trigger)
    - main.c now calls ADC_Polling_Init() instead of ADC_DMA_GPIO_MODE_Config()
    - Added #include "bsp_adc.h" to TimingSet.c
    - DMA continuous mode on PA1 was conflicting with polling-based multi-channel reads in Timing_5ms
    [TimingSet.c, bsp_adc.c, bsp_adc.h, main.c]
2026-05-04 fix: replace garbled Chinese comments with English, fix encoding
    [GeneralTIM.c, GeneralTIM.h, MyTypedef.h, TimingSet.c, TimingSet.h, bsp_Key.c, bsp_Key.h, bsp_beep.c]
2026-05-04 fix: disable JTAG for PB3, move DS18B20 to 1s, clean ADC dead code
    [TimingSet.c, bsp_Key.c, bsp_adc.c, bsp_adc.h, bsp_esp01s.c, bsp_esp01s.h]
2026-05-04 feat: complete auto control - servo feed, fault detection, move relay to main loop
2026-05-04 fix: non-blocking ADC, TIM3 PWM OC, feed logic robustness
    [GeneralTIM.c, TimingSet.c, iwdg.c, main.c, oledChinese_6X12.h, oledChinese_8X16.h, oled_ShowDrive.c, oled_ShowDrive.h]
2026-05-04 fix: restore corrupted OLED files to GBK, re-add manual display features
    [oledChinese_6X12.h, oledChinese_8X16.h, oled_ShowDrive.c, oled_ShowDrive.h, oled_drive.c]
2026-05-04 fix: add TIM3_IRQHandler to prevent system hang on TIM3 update interrupt
2026-05-04 fix: move DS18B20 read from TIM2 ISR to main loop, fix key unresponsiveness
    [TimingSet.c, main.c]
2026-05-04 fix: change keys to pull-up input with low-active detection (more reliable)
    [bsp_Key.c, main.c]
2026-05-04 debug: add TIM2 counter display to verify timer interrupt is firing
2026-05-04 debug: move TIM2 counter to row6 to avoid overlap
    [main.c]
2026-05-04 fix: threshold cursor '>' not clearing - use ternary to always write '>' or space
    [bsp_Key.c, oled_show.c]
2026-05-04 fix: restore oled_show.c clean, fix threshold cursor, re-add manual display features
    [oled_show.c]
2026-05-04 fix: add KEY5 short press handler - was missing KEY_Evt_Press case
    [bsp_Key.c]
2026-05-04 fix: ADC sequential read - read all 3 channels together every 15ms
    [TimingSet.c]
2026-05-04 fix: add ADC EOC timeout protection and stabilization delay
    [TimingSet.c, bsp_adc.c]
2026-05-04 fix: water level ADC scale - max 1.95V (2432) = 100%
    [TimingSet.c]
2026-05-04 fix: manual feed - direct servo control instead of countdown
    [bsp_Key.c]
2026-05-04 fix: TIM3 period 999->19999 for 50Hz servo PWM
    [GeneralTIM.h]
2026-05-04 fix: feedCountdown int16_t with underflow protection
    [MyTypedef.h, TimingSet.c]
2026-05-04 fix: remove static from ShowNum (display bug), always show feed countdown in auto mode
    [oled_ShowDrive.c, oled_show.c]
2026-05-04 fix: simplify feed control logic, ensure servo opens on trigger
    [TimingSet.c]
2026-05-04 删除test部分代码
2026-05-04 fix: add BEEP_DrvScan() to Timing_1ms - was never called, buzzer/LED never triggered
    [TimingSet.c]
2026-05-06 fix: WiFi APP交互修复
    1. TimingSet.c: 喂食周期结束重置autoFeedTimer, 增加舵机安全守卫
    2. TimingSet.c: 自动模式继电器状态变化时主动推送DeviceStatus
    3. bsp_esp01s.c: CMD_SWITCH_MODE/SYNC_THRESHOLDS/SET_FEED_INTERVAL后推送DeviceStatus
    [TimingSet.c, bsp_esp01s.c]
2026-05-08 fix: ESP01S init sequence + buzzer success indication
    - Add AT+RST reset before configuration
    - Add delay after CWSAP for AP to fully start
    - Add retry for CIPSERVER if first attempt fails
    - Add AT+CIFSR to verify AP IP address
    - Improve AT_WaitOK to accept 'no change' response
    - Add 2 short beeps on init success (different from alarm)
    [bsp_esp01s.c]
2026-05-08 fix: ESP01S connection stability - remove post-ack flush, add retry, add debug counters
    [bsp_esp01s.c]
2026-05-14 2026-05-15 标记离线正常的版本
2026-05-14 feat: port ESP-01S driver from verify-esp8266 (remove RST/EN pins)
2026-05-14 feat: refactor USART1 debug (115200) + printf retarget, remove USART3
2026-05-15 feat: replace test data with periodic sensor upload (CMD 0x01, 14 bytes)
    [bsp_esp01s.c, bsp_esp01s.h, main.c]
2026-05-15 fix: reduce ESP send blocking (shorter timeout, no retry, 3s interval)
    [bsp_esp01s.c, main.c]
2026-05-15 feat: add APP command handlers (mode switch, relay control, feed trigger, alarm toggle)
2026-05-19 docs: 添加代码框架文档、坑点经验总结、README；更新项目文档体系
